AndresSM415/Buck_PID/README.md

# Buck_PID
Design of a Buck converter and PID controller implementation using Raspberry PI Pico programmed in C.
For detailed information open the PDF report file
