AndresSM415/Buck_PID/(list of files, drawings)

Other design files:
PCB and electronic Diagram/pcb1.pdsprj
